riverbots42/2024/ledface/gif2pnglist/spinning_ufo.gif

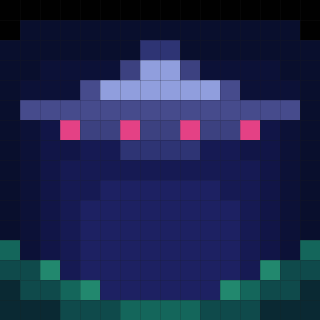
ledface/gif2pnglist/spinning_ufo.gif
