riverbots42/2024/ledface/gif2pnglist/helloworld.gif

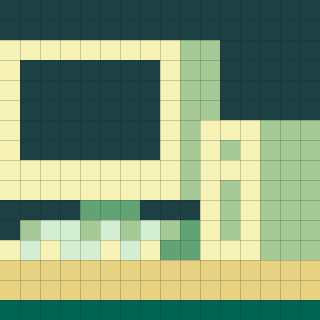
ledface/gif2pnglist/helloworld.gif
