riverbots42/2024/ledface/gif2pnglist/tree_growing.gif

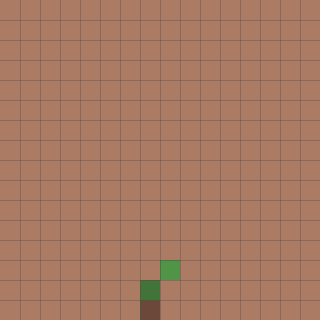
ledface/gif2pnglist/tree_growing.gif
