riverbots42/2024/encoder/sturcde/sturcde.kicad_pcb

## KiCad design encoder/sturcde/sturcde.kicad_pcb (2024-02-24)

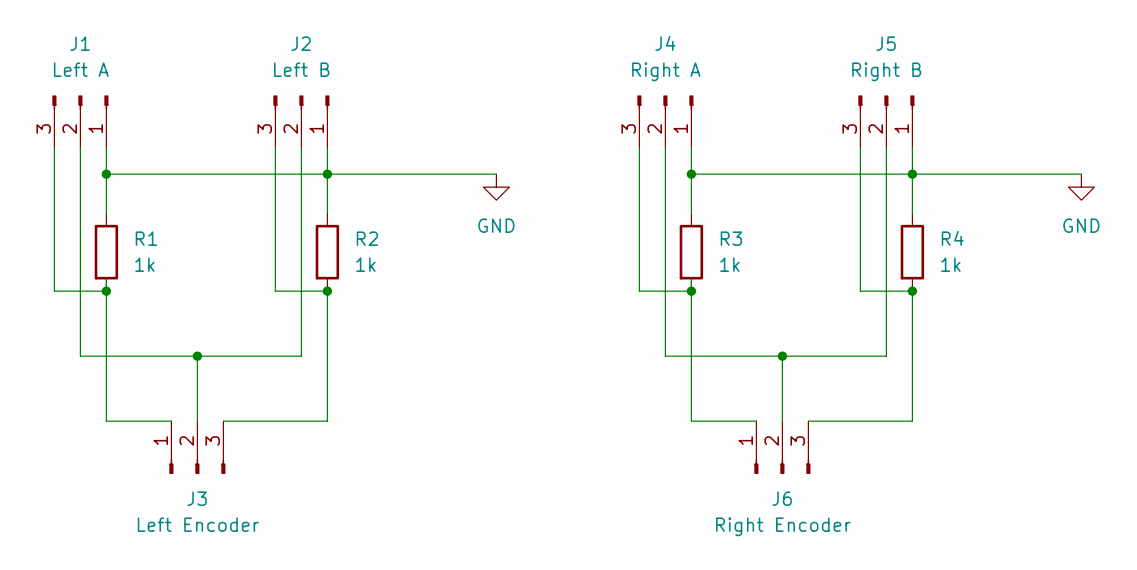
[picture p5: schematic sturcde.kicad_sch, The Stupid Ridiculously-Cheap Drive Encoder]

Parts:
J1: Left A; PinHeader_1x03_P2.54mm_Horizontal
J2: Left B; PinHeader_1x03_P2.54mm_Horizontal
J3: Left Encoder; PinHeader_1x03_P2.54mm_Horizontal
J4: Right A; PinHeader_1x03_P2.54mm_Horizontal
J5: Right B; PinHeader_1x03_P2.54mm_Horizontal
J6: Right Encoder; PinHeader_1x03_P2.54mm_Horizontal
R1, R2, R3, R4: 1k; R_Axial_DIN0207_L6.3mm_D2.5mm_P7.62mm_Horizontal

Connections:
GND: J1.1, J2.1, J4.1, J5.1, R1.1, R2.1, R3.1, R4.1
unnamed: J1.2, J2.2, J3.2
unnamed: J1.3, J3.1, R1.2
unnamed: J2.3, J3.3, R2.2
unnamed: J4.2, J5.2, J6.2
unnamed: J4.3, J6.1, R3.2
unnamed: J5.3, J6.3, R4.2

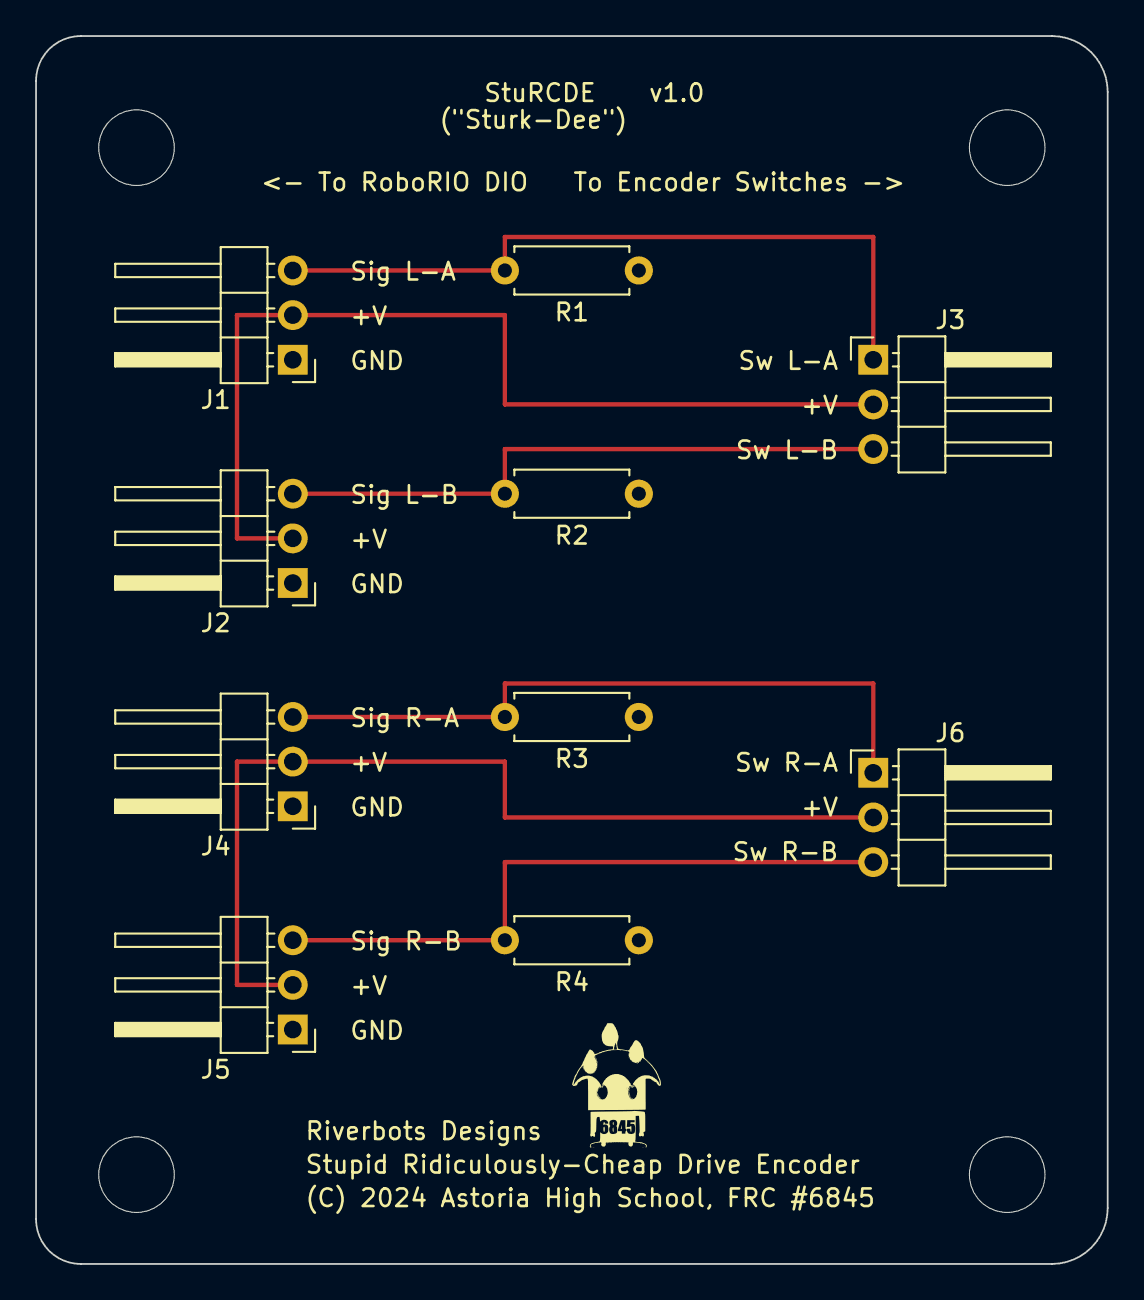
[picture p6: board sturcde.kicad_pcb from above]

Board: 2 copper layers, 61.0 x 69.8 mm, 10 parts (0 on the bottom side), 7 nets.
