riverbots42/2024/(commit log)

2024-01-11 Added 4 motor Differential Drive.
2024-01-11 Added 4 Motor Differential Drive
2024-01-11 Added PhotonVision + unnamed camera
2024-01-19 Ultrasonic Groundwork
2024-01-20 Discovered Ultrasonic Problem
2024-01-25 Auto & Simulation Framework
2024-02-02 Framework For LEDs
2024-02-03 Added Motor Contoller Group basically.
2024-02-03 Working Motors. Quite fast though.
2024-02-03 LED debugging (I want to pull main)
2024-02-04 Add png file filtering and subdirectory scanning.
2024-02-04 Working LED Snake
2024-02-04 Add encoder docs.
2024-02-06 LED suggestions from BJ (can't run yet)
2024-02-07 Small LED Addition and Preperation
2024-02-09 added animation and frame classes
2024-02-09 Untested LED added and VictorSPX import broke
    [Robot.java]
2024-02-10 Aidan fixed com import
    [Robot.java]
2024-02-10 Tiny LED change I can't test yet
2024-02-10 Basic Encoder
2024-02-13 Encoder Code Works
2024-02-13 LED commented out to run teleop
2024-02-13 Winch code modified but not working
    [Robot.java]
2024-02-14 Inverted Wheels
2024-02-14 Add StuRCDE PCB and README.
    [sturcde.kicad_pcb, sturcde.kicad_sch]
2024-02-14 Add logo; general cleanups and prep for pcbway.
    [sturcde.kicad_pcb, sturcde.kicad_sch]
2024-02-17 Swap rows/cols so things show up in the expected order.
    [Main.java]
2024-03-07 Changed FireButton to Driver Preference
2024-03-15 Deleted PathPlanner System We're Going to Localize With AprilTags One Button Fire System
2024-03-19 BJ LED Code
2024-03-20 LEDs Work
