riverbots42/2024/(notices)

Notices in the files:
encoder/sturcde/sturcde.kicad_pcb:
(C) 2024 Astoria High School, FRC #6845
